pico-humanoid/pico-electronics/power/电池方案.md

# 电池与 BMS 方案

更新：2026-10-31。保留原选型：[定制 48V 12Ah 锂电池](https://item.taobao.com/item.htm?id=1051005943737)。以下是仓库原有规格记录；到货铭牌、供应方资料与实测记录仍需对应，不能作为本轮重新测得的结果。

## 规格记录

| 项目 | 原有资料 | 使用边界 |
| --- | --- | --- |
| 串数与电压 | 13S；满电 54.6V、标称 48V、原记录最低 39V | 39V 不是本项目已验证的安全停机阈值，需结合电芯/BMS 与负载压降确定 |
| 容量 | 12Ah（12000mAh） | 续航需结合实际平均功率与可用容量测量 |
| 工作电流 | 原记录 ≤40A | 不是实际运行电流；持续、峰值、持续时间及 BMS 保护值分别确认 |
| 输出接口 | XT60 | 与电源板输入及极性核对；不沿用首页早期 XT90S 候选 |
| BMS | 带 CAN，仓库已有[嘉佰达 CAN 协议](../datasheet/嘉佰达CAN通讯协议定义.docx) | 实物型号、版本、位速率、帧和 ID 仍要核对 |
| 机械 | 90×100×250mm，约 3kg，带开关 | 装配空间、固定、防磨与操作可达性按实物复核 |

## 与 CAN 方案的衔接

BMS 协议资料默认为 500kbit/s、经典 CAN，标准远程帧查询后数据帧回复；关节侧起步为 1Mbit/s。若实物保持不同速率，使用独立 CAN2，不直接并到关节总线上。协议阅读、编解码、实机只读查询与 ID/配置核对由固件侧推进，电气侧落实接口和线束。见固件[通信方案](https://github.com/pico-humanoid/pico-firmware/blob/main/docs/communication/README.md)。

## 到货后补充

1. 电池、BMS、充电器的铭牌和版本，出厂资料及当前到货状态。
2. 电池满电范围、允许持续/峰值电流与峰值时长，BMS 的保护、恢复及回充条件。
3. CAN 插头逐针定义、参考地、位速率、ID 与终端电阻配置。
4. 电池开关、主保护、急停及电源板各自的开断范围和恢复顺序。
5. 与实际线束、接头和负载匹配后的压降、温升与续航记录。

电池已有 BMS 不表示所有线束和支路均获得合适保护。充电器匹配、再生能量和急停后的机械支撑须结合整机方案核对。

[整机供电](供电方案.md) · [待确认事项](../docs/待确认与协作事项.md) · [返回首页](../README.md)
