pico-humanoid/pico-electronics/docs/待确认与协作事项.md

# 待确认事项与分工

更新：2026-10-31。首页旧的三项概念问题已有结论；这里保留会影响装配、上电和联调的实际缺项。下表是建议对接方，不擅自指定个人或承诺完成日期。

## 先处理影响当前工作的事项

| 优先级 | 需要得到的明确答案/记录 | 建议对接方 | 确认前可以做的工作 |
| --- | --- | --- | --- |
| 到货与装配 | PCB、电机是否到货；板是裸板还是贴片；缺哪些器件；可用时间 | 下单/采购人与电气 | 核对现有 BOM、器件手册和装配方向 |
| 制造版本 | 订单对应哪个 CAD/导出；是否包含 H6 绕孔修改；最终 BOM/制造文件在哪里 | 电气/下单人与机械 | 整理设计差异；机械提供螺丝头、垫圈、柱的实际尺寸 |
| 控制侧供电 | 电源板 5V 输出插头及线序、到 J1 的线束、Nucleo 修订版及供电跳线；USB 同接方式 | 电气与固件 | 按手册准备接线图和测点，不直接同时接多个电源 |
| 动力与急停 | 按钮/触点具体型号；接电源板哪个端子；NO/NC 逻辑；切哪些支路；恢复和重新使能顺序 | 电气、固件、机械、控制 | 整理电源板手册已有行为与故障场景，列出需实测差异 |
| 电机接线 | 逐台型号/版本、动力插头、CAN 插头线序、ID、终端是否内置 | 电气与固件；机械核对装配 | 阅读原厂资料，准备只读查询；设备 ID 统一记入固件映射表 |
| 下一次联调 | 谁负责装配/测量/烧录/采集，何时测试，先验收哪一项 | 本轮参与人员 | 准备[分步验收](装配上电与联调.md)及空白记录 |

## 随整机开发补齐

| 事项 | 已明确 | 仍需落实 |
| --- | --- | --- |
| 电池与 BMS | 仓库有 13S/48V、12Ah、XT60 与嘉佰达协议资料 | 到货铭牌、保护/回充参数、实际速率、CAN 端子与 ID |
| 电源板 | 已选 RobStride；有 5V/2A 等输出及独立 CAN 接口 | 实物版本、MODE、预充/泄放和急停接线；状态/电流字段疑点按固件流程核对 |
| 19V 上位机支路 | 保留独立 DC-DC，已有启动演示 | 机载计算机模块/载板型号、DC-DC 铭牌及输入范围、取电点、极性、满载压降和温升 |
| 底板引脚 | 本地网络记录与固件三路选脚一致 | 下单版/实板一致性，第二第三路及 LED/蜂鸣器的固件和实测 |
| 总线分配 | 起步 CAN1 为关节/电源板，CAN2 为不同速率 BMS，CAN3 预留 | 每路节点、目标/反馈频率、线长、终端位置、负载与延迟；共地/参考路径 |
| 线束与集线 | 电源板动力口不带电机 CAN，需要独立通信集线/转接 | 逐针接线、拓扑、分支长度、型号/额定值、固定及防磨；不能默认长星形可用 |
| 上下位机 | 固件汇总设备通信，上位机负责控制目标；原生 USB 与 CAN1 选脚复用冲突已有记录 | 实际物理接口、协议字段、周期、有效期和故障策略；ST-LINK 日志不自动等于正式控制接口 |
| 机械与运动约束 | 当前机械方案为 14 自由度 | 逐关节型号/方向/零位、活动范围、支撑与安全动作 |
| 传感器 | 按后续控制需要接入 | 具体 IMU 等型号、接口、供电、安装方向与时间要求；不把预留当作已装配 |

## 电气与固件怎样交接

- 电气维护最终原理图/PCB、供电与线束、连接器逐针定义、终端位置、装配差异及电气实测记录。
- 固件维护外设配置、协议编解码、设备 ID/映射、采集日志、超时与状态机；读取已有 BMS/电源板协议后再询问具体歧义。
- 机械提供紧固件外廓、线束运动空间、关节方向/零位/范围；控制与固件共同确定目标语义、周期及异常动作。
- 实机动作前共同确认对应的供电、限值和停止条件。数据恢复不自动意味着允许重新使能。

沿用固件[协作说明](https://github.com/pico-humanoid/pico-firmware/blob/main/docs/collaboration/README.md)及其中的接口、关节和故障表，电气补充真实接线和变更，避免在两个仓库重复维护不同的 ID/指令顺序。

记录每项结论时写清：问题、依据/版本、结论、确认人、日期、下一动作与预计时间。未确认保持“待确认”，不填为零或默认通过。

[装配上电与联调](装配上电与联调.md) · [返回首页](../README.md)
