pico-humanoid/pico-electronics/docs/设计与验证记录.md

# 资料依据、设计与验证记录

整理日期：2026-10-31。本轮完善电气文档、统一已有结论与待办，不修改原理图、PCB、制造订单或固件，也没有重跑硬件实验。

## 本轮依据

| 来源 | 本轮采用内容 | 不能据此认定的事项 |
| --- | --- | --- |
| [电气原仓库 22e90a6](https://github.com/pico-humanoid/pico-electronics/tree/22e90a634d3848723aef2631b6c89dda114aec15) | 电池、RobStride 电源板、独立 19V 模块、5V/2A 底板供电、TJA1051 与已有手册 | 购买清单或商品标称不代表实物全部到齐和验收完成 |
| [固件基线 69b0dc3](https://github.com/pico-humanoid/pico-firmware/tree/69b0dc3e6d2fc8b7fde77e7837b17861bf3dc476) | G474 平台、三路 CAN 选脚、经典 CAN 分路、现有实验与后续职责 | 原模块 FDCAN1 实验不代表新底板三路或真实电机已通过 |
| 电源板 V1.5 手册第 4–6 页 | 输入/输出参数、时序、保护、预充/泄放及 CAN 默认参数 | 默认配置不自动适合整机；急停作用范围需实际接线验证 |
| 10/27 本地 CAD 保存与检查记录 | 共享“主板v1.0 / 第1次改进”；TVS/终端布局、原生等长与 H6 绕孔；DRC 141 项、0 错误 | 本记录非本轮重新检查；未证明订单包含最后修改、实板功能或阻抗/EMC 通过 |
| 10/29 采购状态沟通 | PCB 已下单，等待到货 | 10/31 未获得新的到货/贴片/电机交付确认 |
| 团队电源初测分享 | 19V 机载计算机启动、主电源初步测试 | 未获得完整负载、压降、电流、温升与持续时间记录 |

CAD 的接口核对采用本地保存的焊盘网络记录：CN7/CN10 的 CAN、BUZZER、LED_G/LED_R 与固件已选脚对应。该核对不替代订单和实板的导通、供电检查。

## 已整理到文档的结论

- 用现成 NUCLEO-G474RE 作为核心板，外接三颗 TJA1051T/3，三个小终端开关按通道布置。
- 底板使用电源板已有的 5V/2A，机载计算机保留独立 19V 模块；不再把额外 48V→5V 模块写成必需。
- 起步使用经典 CAN；不同速率的 BMS 与关节分路。收发器型号和控制器能力不能代替整链 CAN FD 验证。
- 现用动力电源板不带电机 CAN 集线功能，动力和通信线束分别规划。
- 电源板参数、电池原有参数、选脚、设计检查与实物验收分别记录；未确认的实际值不填成默认成功。

## 仍需归档的工程资料

1. **实际下单版本**的工程/制造文件、日期与校验值，及其与 H6 最后修改的关系。
2. 最终原理图、PCB、装配 BOM、缺件/代料、共享工程版本索引。原仓库的 MCU/电源板资料图片不能代替最新工程。
3. 底板完整外观和装配图，D1–D3、SW1–SW3、H6 的检查证据；具体 CAD 检查文件与导出归档。
4. 电池、BMS、电源板、DC-DC、机载计算机及电机的实物铭牌和对应手册版本。
5. 线束图、端子线序、终端位置、供电/急停实测及按阶段采集的原始日志。

上述工程和原始测试文件尚未随本轮文档一并上传，不能把文档中的设计摘要当成可直接生产的文件包。后续按[装配上电与联调](装配上电与联调.md)记录实际结果，再更新首页状态。

[PCB 方案](../board/PCB方案.md) · [待确认事项](待确认与协作事项.md) · [返回首页](../README.md)
