pico-humanoid/pico-electronics/assets/mcu.png

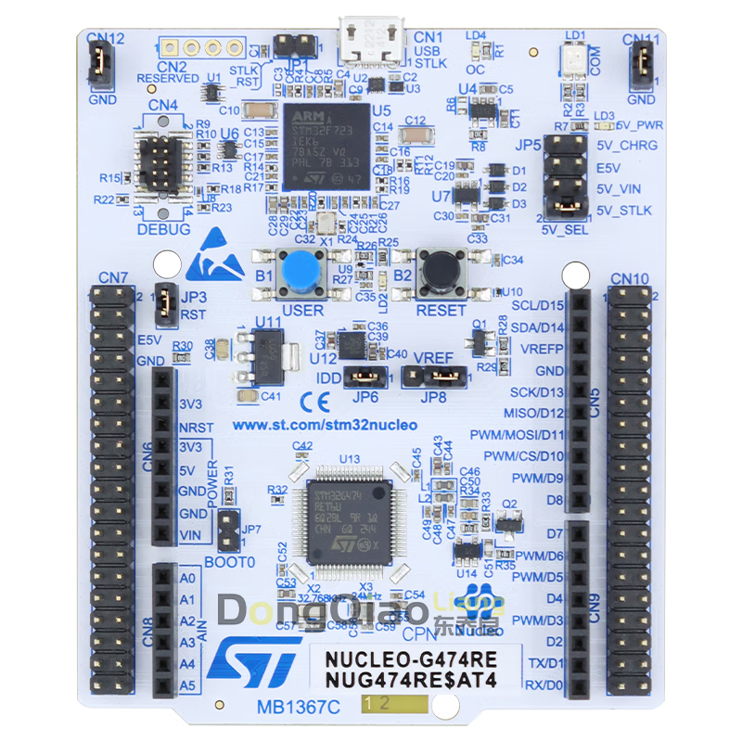
assets/mcu.png
