pico-humanoid/pico-electronics/BOM/PICO器件购买清单1016_杨宸涵.xlsx

产品 | 单价 | 数量 | 小计 | 使用人 | 备注（购买链接）
定制48V12AH锂电池 | ¥2500.00 | 1 | ¥2500.00 | 杨宸涵 | https://item.taobao.com/item.htm?id=1051005943737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 90-100-250mm内 48V12AH 索尼。设备电流40A 放电XT60母头，配CAN通讯 ，已商谈报价2500元
XT30 2+2转GH1.25+XT30 | ¥10.00 | 4 | ¥40.00 | 杨宸涵 | https://item.taobao.com/item.htm?id=815810342495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
XT30（2+2）双端（18awg+26awg 200mm） | ¥15.00 | 10 | ¥150.00 | 杨宸涵 | https://item.taobao.com/item.htm?id=815810342495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
XT30（2+2）单端（18awg+26awg 100mm） | ¥8.00 | 10 | ¥80.00 | 杨宸涵 | https://item.taobao.com/item.htm?id=815810342495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
GH1.25-2pin异面线 | ¥3.50 | 8 | ¥28.00 | 杨宸涵 | https://item.taobao.com/item.htm?from=cart&id=815810342495&upStreamPrice=350&xxc=taobaoSearch
合计 | ￥2798.00
