pico-humanoid/pico-electronics/BOM/PICO器件购买清单1022_杨宸涵.xlsx

产品 | 单价 | 数量 | 小计 | 使用人 | 备注（购买链接）
48V转19V直流电源转换器（5A） | ¥27.00 | 1 | ¥27.00 | 杨宸涵 | https://item.jd.com/10138079795809.html
施耐德急停按钮开关-XB2BS545C 旋转复位 1开1闭 | ¥24.00 | 1 | ¥24.00 | 杨宸涵 | https://item.taobao.com/item.htm?ali_trackid=282_8e9d2e965dc4d03e812bef6c4869563c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
2464 18号DC5525黑音叉弯头 | ¥6.24 | 2 | ¥12.48 | 杨宸涵 | https://item.jd.com/10177970571269.html
热缩管黑色 2米 圆内径Φ5 | ¥10.21 | 1 | ¥10.21 | 杨宸涵 | https://item.jd.com/10236257948665.html?purchasetab=dpgm
热缩管红色 2米 圆内径Φ5 | ¥10.21 | 1 | ¥10.21 | 杨宸涵 | https://item.jd.com/10236257948666.html?purchasetab=dpgm
透明扁管Φ28mm 2米 内孔扁宽455mm | ¥15.13 | 1 | ¥15.13 | 杨宸涵 | https://item.jd.com/10236257271644.html?purchasetab=dpgm
合计 | ￥99.03
