pico-humanoid/pico-electronics/BOM/PICO器件购买清单1014_杨宸涵.xlsx

产品 | 单价 | 数量 | 小计 | 使用人 | 备注（购买链接）
灵足时代电机模组ROBSTRIDE 10P（含CAN调试） | ¥899.00 | 1 | ¥899.00 | 杨宸涵 | https://item.taobao.com/item.htm?id=1079314226848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
灵足时代关节电机模组ROBSTRIDE00（含CAN调试） | ¥638.00 | 1 | ¥638.00 | 杨宸涵 | https://item.taobao.com/item.htm?abbucket=0&id=854268859209&ns=1&skuId=5823819118764&xxc=taobaoSearch
灵足时代 多功能电源管理模块 | ¥399.00 | 1 | ¥399.00 | 杨宸涵 | https://item.taobao.com/item.htm?abbucket=0&id=1025248375262&ns=1&skuId=6202661899589&xxc=taobaoSearch
合计 | ￥1936.00
