pico-humanoid/pico-electronics/model/POWER_PCB_V1.3_1105.step

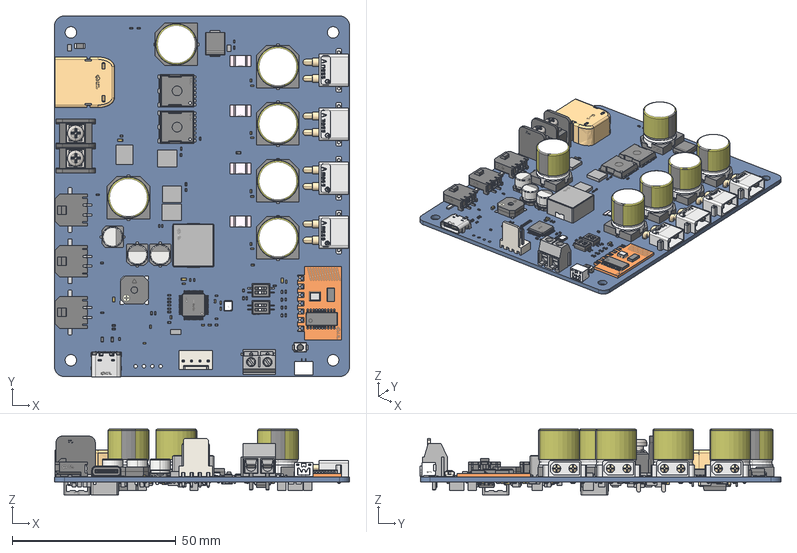
[picture p3: CAD file, 2026-10-14, last stored version]
model/POWER_PCB_V1.3_1105.step
90.0 x 110.1 x 20.1 mm
R0603 x 13
C0402-H0P5MM x 42
c0603-h0p8mm x 13
Extruded x 40
BUZ-SMD_4P-L8.5-W8.5-P8.50-BR~BUZ-SMD_4P-L8.5-W8.5-H3.0~X4gc
CAP-SMD_BD12.5-L13.0-W13.0-LS14.4-FD~CAP-SMD_ BD12.5-L13.0-W13.0-LS14.4-FD~YFp3 x 6
CONN-TH_KF7.62-2P~CONN-TH_KF7.62-2P~pqOa
CONN-TH_KF7.62-2P~CONN-TH_KF7.62-2P~pqOa001
CONN-TH_KF7.62-2P~CONN-TH_KF7.62-2P~pqOa002
CONN-TH_KF7.62-2P~CONN-TH_KF7.62-2P~pqOa003
CONN-TH_KF7.62-2P~CONN-TH_KF7.62-2P~pqOa004
CONN-TH_KF7.62-2P~CONN-TH_KF7.62-2P~pqOa005
CONN-TH_KF7.62-2P~CONN-TH_KF7.62-2P~pqOa006
CONN-TH_KF7.62-2P~CONN-TH_KF7.62-2P~pqOa007
CONN-TH_KF7.62-2P~CONN-TH_KF7.62-2P~pqOa008
CONN-TH_KF7.62-2P~CONN-TH_KF7.62-2P~pqOa009
CONN-TH_KF7.62-2P~CONN-TH_KF7.62-2P~pqOa010
CONN-TH_KF7.62-2P~CONN-TH_KF7.62-2P~pqOa011
CONN-TH_KF7.62-2P~CONN-TH_KF7.62-2P~pqOa012
CONN-TH_KF7.62-2P~CONN-TH_KF7.62-2P~pqOa013
CONN-TH_KF7.62-2P~CONN-TH_KF7.62-2P~pqOa014
CONN-TH_2P-P5.00_WJ301V-5.00-2P~CONN-TH_2P-P5.00_WJ301V-5.00-2P~HdCe
CONN-TH_2P-P5.00_WJ301V-5.00-2P~CONN-TH_2P-P5.00_ WJ301V-5.00-2P~HdCe001
CONN-TH_2P-P5.00_WJ301V-5.00-2P~CONN-TH_2P-P5.00_ WJ301V-5.00-2P~HdCe002
CONN-TH_2P-P5.00_WJ301V-5.00-2P~CONN-TH_2P-P5.00_ WJ301V-5.00-2P~HdCe003
CONN-TH_2P-P5.00_WJ301V-5.00-2P~CONN-TH_2P-P5.00_ WJ301V-5.00-2P~HdCe004
CONN-TH_2P-P5.00_WJ301V-5.00-2P~CONN-TH_2P-P5.00_ WJ301V-5.00-2P~HdCe005
SMC_L6.9-W5.9-LS8.0-RD~SMC_L6.9-W5.9-LS8.0-RD~o7ff x 2
IND-SMD_L13.4-W12.6~IND-SMD_L13.4-W12.6-H6.5~WJnp
IND-SMD_L13.4-W12.6~IND-SMD_L13.4-W12.6-H6.5~WJnp001
IND-SMD_L13.4-W12.6~IND-SMD_L13.4-W12.6-H6.5~WJnp002
IND-SMD_L8.5-W8.0_PCC-M0854M~IND-SMD_L8.5-W8.0_PCC-M0854M~ksQ5 x 2
IND-SMD_L8.5-W8.0_PCC-M0854M~IND-SMD_L8.5-W8.0_PCC-M0854M~ksQ006 x 2
IND-SMD_L8.5-W8.0_PCC-M0854M~IND-SMD_L8.5-W8.0_PCC-M0854M~ksQ007 x 2
TOLL-8_L10.4-W9.9-P1.20-LS11.7-BL_2~TOLL-8_L10.4-W9.9-P1.20-LS11.7-BL_ 2~OzjH x 2
SW-SMD_L3.9-W3.0-P4.45~SW-SMD_L3.9-W2.9-H2.0-LS4.8~hJLa
SW-SMD_L3.9-W3.0-P4.45~SW-SMD_L3.9-W2.9-H2.0-LS4.8~hJLa001
SW-SMD_L3.9-W3.0-P4.45~SW-SMD_L3.9-W2.9-H2.0-LS4.8~hJLa002
SW-SMD_L3.9-W3.0-P4.45~SW-SMD_L3.9-W2.9-H2.0-LS4.8~hJLa003
SW-SMD_L3.9-W3.0-P4.45~SW-SMD_L3.9-W2.9-H2.0-LS4.8~hJLa004
SW-SMD_L3.9-W3.0-P4.45~SW-SMD_L3.9-W2.9-H2.0-LS4.8~hJLa005
SW-SMD_L3.9-W3.0-P4.45~SW-SMD_L3.9-W2.9-H2.0-LS4.8~hJLa006
SW-SMD_L3.9-W3.0-P4.45~SW-SMD_L3.9-W2.9-H2.0-LS4.8~hJLa007
SW-SMD_L3.9-W3.0-P4.45~SW-SMD_L3.9-W2.9-H2.0-LS4.8~hJLa008
SW-SMD_L3.9-W3.0-P4.45~SW-SMD_L3.9-W2.9-H2.0-LS4.8~hJLa009
SW-SMD_L3.9-W3.0-P4.45~SW-SMD_L3.9-W2.9-H2.0-LS4.8~hJLa010
SW-SMD_L3.9-W3.0-P4.45~SW-SMD_L3.9-W2.9-H2.0-LS4.8~hJLa011
SW-SMD_L3.9-W3.0-P4.45~SW-SMD_L3.9-W2.9-H2.0-LS4.8~hJLa012
SW-SMD_L3.9-W3.0-P4.45~SW-SMD_L3.9-W2.9-H2.0-LS4.8~hJLa013
SW-SMD_L3.9-W3.0-P4.45~SW-SMD_L3.9-W2.9-H2.0-LS4.8~hJLa014
SW-SMD_L3.9-W3.0-P4.45~SW-SMD_L3.9-W2.9-H2.0-LS4.8~hJLa015
SW-SMD_2P-L5.4-W4.1-P1.27-LS8.4~SW-SMD_2P-L5.4-W4.1-P1.27-LS8.4~4nNI x 2
CONN-TH_XT30PW-M~CONN-TH_XT30PW-M~6sY7 x 4
WIRELM-TH_LING-R1A-V1.0~WIRELM-TH_LING-R1A-V1.0~sHrj
WIRELM-TH_LING-R1A-V1.0~WIRELM-TH_LING-R1A-V1.0~sHrj001
WIRELM-TH_LING-R1A-V1.0~WIRELM-TH_LING-R1A-V1.0~sHrj002
WIRELM-TH_LING-R1A-V1.0~WIRELM-TH_LING-R1A-V1.0~sHrj003
WIRELM-TH_LING-R1A-V1.0~WIRELM-TH_LING-R1A-V1.0~sHrj004
WIRELM-TH_LING-R1A-V1.0~WIRELM-TH_LING-R1A-V1.0~sHrj005
WIRELM-TH_LING-R1A-V1.0~WIRELM-TH_LING-R1A-V1.0~sHrj006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
