pico-humanoid/pico-electronics/(commit log)

2026-10-13 添加电气设计项目的 README 文档
2026-10-14 添加BOM
    [PICO器件购买清单1014_杨宸涵.xlsx]
2026-10-14 添加电源板说明书及3D模型
    [PICO器件购买清单1014_杨宸涵.xlsx, POWER_PCB_V1.3_1105.step]
2026-10-14 更新 README 文档并补充电池方案
2026-10-16 添加供电方案文档及 BOM，并更新 README 采用 RobStride 电源板方案
    [PICO器件购买清单1016_杨宸涵.xlsx, POWER_PCB_V1.3_1105.step]
2026-10-16 更新器件手册
2026-10-19 更新供电方案文档并添加 PICO 器件购买清单
    [PICO器件购买清单10xx_杨宸涵.xlsx]
2026-10-19 修正笔误
2026-10-19 更新 README 并添加待沟通问题
2026-10-22 更新 PICO 器件购买清单并添加 .gitignore
    [PICO器件购买清单1022_杨宸涵.xlsx, PICO器件购买清单10xx_杨宸涵.xlsx]
2026-10-25 添加主板方案文档并更新数据手册路径
2026-10-31 docs: 补充电气协作事项、装配联调与验证记录
2026-10-31 docs: 完善G474底板电路、CAN接口与PCB方案
2026-10-31 docs: 完善整机供电、电池BMS与电源线束方案
2026-10-31 docs: 更新电气首页进度、供电PCB方案与CAN结论
